ManuelMP3443/ALU-4-Bits/(list of files, drawings)

Other design files:
ALU.circ
